doitms-com/open-source-house/desenhos/mapa-vaos/dc-t1.md

# Mapa de vãos — DC-T1

Quadro de referência gerado a partir do modelo geométrico do DC-T1 (estado base, sem opções). Material de referência: não é projecto de execução nem dispensa profissionais habilitados (ver o aviso da publicação, AVISO.md).

**Total: 11 vãos** (7 janelas, 2 portas exteriores, 2 portas interiores).

| ID | Tipo | Orientação | Largura (m) | Altura (m) | Peitoril (m) | Área (m²) | Batente | Descrição pública | Centro X (m) | Centro Y (m) | Centro Z (m) | Material caixilho | Vidro | U_f (W/m²·K) | U_w global (W/m²·K) | g_T,vi | R_w + C + Ctr (dB) | Permeabilidade NP EN 12207 | Verificação (indicativa) |
|---|---|---|---|---|---|---|---|---|---|---|---|---|---|---|---|---|---|---|---|
| J01 | janela | Sul | 1.20 | 1.20 | 1.04 | 1.44 | direita | Janela — Sul | 2.31 | 0.12 | 1.64 | Alumínio RPT (poliamida 24 mm) | Vidro duplo 4 (low-e) + 16 Ar + 4 mm | 2.80 | 1.40 | 0.50 | 32 (-1; -4) | 4 | REH §6 OK · RECS-A 26 dB OK · NP EN 14351-1 |
| J02 | janela | Sul | 0.60 | 0.60 | 1.71 | 0.36 | basculante | Janela — Sul | 7.58 | 0.12 | 2.01 | Alumínio RPT (poliamida 24 mm) | Vidro duplo translúcido 4-16Ar-4 | 2.80 | 1.60 | 0.40 | 30 (-1; -3) | 4 | REH §6 OK (ventilação IS) · NP EN 14351-1 |
| J03 | janela | Este | 1.20 | 1.20 | 1.04 | 1.44 | direita | Janela — Este | 8.88 | 4.49 | 1.64 | Alumínio RPT (poliamida 24 mm) | Vidro duplo 4 (low-e) + 16 Ar + 4 mm | 2.80 | 1.40 | 0.50 | 32 (-1; -4) | 4 | REH §6 OK · RECS-A 26 dB OK · NP EN 14351-1 |
| J04 | janela | Norte | 0.90 | 1.30 | 0.80 | 1.17 | direita | Janela — Norte | 1.85 | 5.88 | 1.45 | Alumínio RPT (poliamida 24 mm) | Vidro duplo 4 (low-e) + 16 Ar + 4 mm | 2.80 | 1.40 | 0.50 | 32 (-1; -4) | 4 | REH §6 OK · RECS-A 26 dB OK · NP EN 14351-1 |
| J05 | janela | Norte | 0.90 | 1.30 | 0.80 | 1.17 | esquerda | Janela — Norte | 4.80 | 5.88 | 1.45 | Alumínio RPT (poliamida 24 mm) | Vidro duplo 4 (low-e) + 16 Ar + 4 mm | 2.80 | 1.40 | 0.50 | 32 (-1; -4) | 4 | REH §6 OK · RECS-A 26 dB OK · NP EN 14351-1 |
| J06 | janela | Norte | 0.90 | 1.30 | 0.80 | 1.17 | direita | Janela — Norte | 6.00 | 5.88 | 1.45 | Alumínio RPT (poliamida 24 mm) | Vidro duplo 4 (low-e) + 16 Ar + 4 mm | 2.80 | 1.40 | 0.50 | 32 (-1; -4) | 4 | REH §6 OK · RECS-A 26 dB OK · NP EN 14351-1 |
| J07 | janela | Oeste | 1.20 | 1.20 | 1.04 | 1.44 | esquerda | Janela — Oeste | 0.12 | 4.49 | 1.64 | Alumínio RPT (poliamida 24 mm) | Vidro duplo 4 (low-e) + 16 Ar + 4 mm | 2.80 | 1.40 | 0.50 | 32 (-1; -4) | 4 | REH §6 OK · RECS-A 26 dB OK · NP EN 14351-1 |
| PE01 | porta_exterior | Sul | 0.90 | 2.10 | 0.00 | 1.89 | esquerda | Porta exterior — Sul | 5.45 | 0.12 | 1.05 | Madeira maciça + alma isolante PIR 30 mm | Sem envidraçado (porta cega) | 1.80 | 1.80 | — | 38 (-1; -3) | 3 | REH §6 OK · RECS-A 32 dB OK · NP EN 14351-1 |
| PE02 | porta_exterior | Norte | 0.90 | 2.10 | 0.00 | 1.89 | direita | Porta exterior — Norte | 7.59 | 5.88 | 1.05 | Madeira maciça + alma isolante PIR 30 mm | Sem envidraçado (porta cega) | 1.80 | 1.80 | — | 38 (-1; -3) | 3 | REH §6 OK · RECS-A 32 dB OK · NP EN 14351-1 |
| PI01 | porta_interior | — | 0.80 | 2.10 | 0.00 | 1.68 | esquerda | Porta interior | 3.90 | 3.00 | 1.05 | MDF lacado + alma colmeia | — | 2.50 | 2.50 | — | 25 (-1; -2) | 1 | DL 220/2008 (acústica entre compartimentos) OK |
| PI02 | porta_interior | — | 0.80 | 2.10 | 0.00 | 1.68 | esquerda | Porta interior | 6.45 | 2.45 | 1.05 | MDF lacado + alma colmeia | — | 2.50 | 2.50 | — | 25 (-1; -2) | 1 | DL 220/2008 (acústica entre compartimentos) OK |

Valores indicativos: não constituem verificação de conformidade (ver AVISO).

Convenções: medidas em metros; o centro do vão está no referencial do modelo (X para Este, Y para Norte, Z na vertical); a orientação é a da face exterior («—» onde não se aplica, como nas portas interiores).
