doitms-com/open-source-house/engenharia/iluminacao/iluminacao-artificial-dc-t1.md

> **Estado do conteúdo de engenharia** (cabeçalho gerado)
>
> Cabeçalho gerado a partir do próprio relatório: diz o que está provisório, por preencher ou por cumprir, antes do corpo.
>
> - **Assinatura.** Documento não assinado: sem assinatura de técnico habilitado; o relatório não foi revisto por técnico com inscrição válida.
>
> Documento técnico de referência: não é projecto e não serve para construir sem profissionais licenciados (ver `AVISO.md`, na raiz da publicação).

# Iluminação artificial — Casa Base T1 (`DC-T1`)

Projecto luminotécnico por compartimento (EN 12464-1 adaptada a residencial; LED CRI ≥ 90).

| Compartimento | Área (m²) | Lux alvo | Pontos LED | Potência (W) | CCT (K) |
|---|---|---|---|---|---|
| Sala / Cozinha aberta (com hall) | 22.95 | 200 | 4 | 64 | 3000 |
| Quarto principal | 11.34 | 100 | 2 | 16 | 2700 |
| Casa de banho | 6.08 | 200 | 3 | 17 | 3500 |
| Hall (aberto à sala) | 5.0 | 200 | 3 | 14 | 3000 |

**Potência LED total: 111 W** — circuito C1 (10 A / 1.5 mm²). Daylight factors em `lux-daylight-*.csv`.
