doitms-com/open-source-house/AVISO.md

# Aviso

Os desenhos, os ficheiros 3D, os cálculos e a documentação de serviços do DC-T1 (selo do modelo `c2d1ffeb79f1`) são **documentação técnica de referência**. Leia este aviso antes de usar qualquer ficheiro desta publicação.

1. **Não é um projecto.** Não é projecto de licenciamento nem de execução. Não foi submetida nem aprovada por nenhuma câmara municipal ou outra entidade, e não deve ser apresentada como tal.
2. **Não tem termo de responsabilidade.** Não tem termo de responsabilidade de arquitecto nem de engenheiro, nem assinatura de técnico. Não substitui o projecto subscrito por técnico com inscrição válida na Ordem dos Arquitectos (arquitectura) ou na Ordem dos Engenheiros (especialidades).
3. **Não construa sem profissionais habilitados.** Não construa nem encomende a construção de qualquer edifício a partir destes ficheiros sem projecto e direcção de obra por profissionais habilitados e sem as licenças e autorizações exigidas por lei. Esta documentação não serve para construir sem profissionais licenciados.
4. **Verifique tudo.** Verifique cada elemento contra o terreno, o plano director municipal, os regulamentos e a lei em vigor. Esta documentação não tem em conta o terreno, a zona, o clima local nem as condições de qualquer lote concreto.
5. **O conteúdo de engenharia é provisório.** Os cálculos são publicados com o estado que têm: provisórios, por rever e por assinar, com campos por preencher e resultados que podem não cumprir os requisitos. Cada relatório começa por um cabeçalho de estado que o diz, e o README tem a secção «Estado do conteúdo de engenharia». Nada aqui garante que a casa cumpra um regulamento.
6. **Sem garantia.** Na medida permitida pela lei, a documentação é fornecida «tal como está», sem garantia de exactidão, de completude ou de adequação a qualquer fim, e quem a usa fá-lo por sua conta e risco (ver a secção 5 do texto da licença, em [LICENSE](LICENSE)).

A licença CC BY-SA 4.0 permite copiar, adaptar e usar esta documentação; este aviso não a limita, mas aplica-se a todas as cópias e adaptações. As folhas de desenho repetem o aviso na legenda.
