doitms-com/open-source-house/MARCA.md

# Marca

«Doitms», «DOITMS», «Doitms Casa» e o logótipo da Doitms Casa são sinais distintivos reservados. **Não estão licenciados.**

A licença CC BY-SA 4.0 desta documentação cobre os direitos de autor sobre os desenhos, relatórios, tabelas e ficheiros 3D publicados. O texto da licença diz expressamente que os direitos de marca e de patente não são licenciados (secção 2(b)(2)) e que nada nela dá permissão para sugerir ligação, patrocínio ou aprovação do licenciante (secção 2(a)(6)).

## O que pode fazer

- Citar o nome «Doitms Casa» para identificar a origem desta documentação, com a atribuição pedida no README («Como citar»).
- Dizer, com verdade, que a sua obra se baseia na documentação do DC-T1 da Doitms Casa.
- Nas adaptações, remova o logótipo da legenda ou mantenha-o apenas como indicação de origem, sem o usar como marca própria.

## O que não pode fazer

- Usar «Doitms», «DOITMS», «Doitms Casa» ou o logótipo como nome ou sinal de um produto, de uma obra, de uma empresa, de um serviço, de um domínio ou de um repositório seu.
- Dar a uma obra derivada (uma adaptação desta documentação) o nome ou o logótipo, ou apresentá-la de modo que sugira que foi feita, aprovada ou patrocinada pela Doitms Casa.
- Omitir que alterou o material: a licença exige que indique as alterações.

Para qualquer outro uso do nome ou do logótipo, peça autorização antes, abrindo um *issue* neste repositório (https://github.com/doitms-com/open-source-house/issues).
