doitms-com/open-source-house/engenharia/memoria-reh.md

> **Estado do conteúdo de engenharia** (cabeçalho gerado)
>
> Cabeçalho gerado a partir do próprio relatório: diz o que está provisório, por preencher ou por cumprir, antes do corpo.
>
> - **Limitações que o próprio relatório imprime.** 2 pendências declaradas no corpo; não foram escondidas nem resolvidas aqui.
> - **Assinatura.** Documento não assinado: sem assinatura de técnico habilitado; o relatório não foi revisto por técnico com inscrição válida.
>
> Documento técnico de referência: não é projecto e não serve para construir sem profissionais licenciados (ver `AVISO.md`, na raiz da publicação).

# Doitms Casa — Verificação REH preparatória (DL 101-D/2020 + Portaria 138-I/2021)

**Âmbito.** Verificação dos requisitos mínimos de qualidade térmica
(U_max por elemento, factor solar dos vãos, ventilação Rph ≥ 0.4 h⁻¹)
para o projecto-tipo Doitms nas dimensões legais (T1 9.0 × 6.0 m,
Ab 54.0 m²),
na zona climática de referência (I1/V2).

**O que este documento NÃO é.** O cálculo sazonal completo do REH
(Nic ≤ Ni, Nvc ≤ Nv, Ntc ≤ Nt, com edifício de referência), a classe
energética e o pré-certificado/certificado SCE são actos próprios do
**Perito Qualificado (PQ)** — PENDENTES. Este quadro garante que o
projecto-tipo cumpre os requisitos mínimos à partida (a classe alvo A exige o cálculo completo do PQ).

| ZI | ZV | U parede (max) | U cob. (max) | U pav. (max) | U vãos (max) | g_T (max) | Rph | Conforme |
|---|---|---|---|---|---|---|---|---|
| I1 | V2 | 0.260 (0.50) | 0.18 (0.40) | 0.32 (0.50) | 1.40 (2.80) | 0.38 (0.56) | 0.45 | ✓ |

**Resultado: zona climática de referência (I1/V2) conforme** com os
requisitos mínimos da Portaria 138-I/2021.

**Notas de projecto.**

1. U das paredes obtido do modelo higrotérmico (ficheiro não publicado) para o envelope da zona climática de referência (I1/V2), JÁ COM a correcção de pontes térmicas dos
   montantes LGSF (método combinado EN ISO 6946 §6.7; ver ficheiro não publicado, coluna «U corrigido»); o PQ valida com
   cálculo numérico ISO 10211 se necessário.
2. Ventilação: admissão por grelhas higrorreguláveis
   na sala e quartos (compartimentos principais) + extracção mecânica
   permanente nos compartimentos de serviço — extractor higrorregulável por casa de banho (NP 1037-1: IS c/ banheira/duche ≥ 45 m³/h) e o exaustor de cozinha com conduta Ø125 (compra do cliente) na cozinha (NP 1037-1 cozinha ≥ 60 m³/h). Ponto
   eléctrico dedicado em ficheiro não publicado. Rph projecto 0.45
   h⁻¹ ≥ 0.4.
3. Vãos: caixilharia com corte térmico + vidro duplo low-e; estore
   exterior = sombreamento activado para g_T.
4. **Pendente (obrigatório antes da licença): cálculo REH completo +
   pré-certificado SCE por PQ; certificado SCE na conclusão.**
