doitms-com/open-source-house/servicos/ficha-scie-dc-t1.md

> **Estado do conteúdo de engenharia** (cabeçalho gerado)
>
> Cabeçalho gerado a partir do próprio relatório: diz o que está provisório, por preencher ou por cumprir, antes do corpo.
>
> - **Limitações que o próprio relatório imprime.** 1 pendência declarada no corpo; não foram escondidas nem resolvidas aqui.
> - **Campos.** Há 10 campos por preencher, entre parênteses rectos ([morada da obra], [freguesia], [concelho], [distrito], [nome do dono da obra], [NIF do dono da obra], [nome do técnico responsável], [n.º de inscrição do técnico], [distância], [localização do hidrante]): dependem do lote, do dono da obra ou de um técnico e estão vazios.
> - **Assinatura.** Documento não assinado: sem assinatura de técnico habilitado; o relatório não foi revisto por técnico com inscrição válida.
> - **Incoerência conhecida.** Cobertura descrita como telhado inclinado (versão anterior); a casa base tem cobertura plana (folha DA.02).
>
> Documento técnico de referência: não é projecto e não serve para construir sem profissionais licenciados (ver `AVISO.md`, na raiz da publicação).

# Ficha de Segurança Contra Incêndio — UT I, 1.ª Categoria · DC-T1

**Regime.** DL n.º 220/2008 (SCIE) + Portaria n.º 1532/2008. Habitação
unifamiliar — **Utilização-Tipo I**, 1 piso, altura ≤ 3.5 m,
**1.ª categoria de risco** ⇒ dispensa de projecto de
especialidade SCIE (Art. 17.º); sujeita a ficha de segurança (modelo ANEPC).

**Produto.** Casa Base T1 (`DC-T1`).
**Local da obra.** [morada da obra] · [freguesia] · [concelho] ·
[distrito]. **Dono da obra.** [nome do dono da obra], NIF [NIF do dono da obra].
**Técnico responsável.** [nome do técnico responsável], [n.º de inscrição do técnico].

---

## 1. Caracterização (valores do modelo paramétrico)

| Parâmetro | Valor |
|---|---|
| Utilização-tipo | I — habitacional |
| N.º de pisos acima do plano de referência | 1 |
| Altura da UT | ≤ 3.5 m |
| Área bruta | 54.0 m² |
| Categoria de risco | 1.ª |
| Local de risco | A (habitação) |
| N.º de saídas para o exterior | **2 (fachadas opostas, acima do exigido)** |
| Distância máxima a uma saída | ≤ 10.8 m (diagonal do envelope) |

Saídas (do modelo):

  1. 0.90 × 2.10 m — Porta principal — face Sul (hall)
  2. 0.90 × 2.10 m — Porta de serviço — Norte, inserto no vão Cozinha; 2.ª saída de emergência

## 2. Condições exteriores e acessibilidade dos meios de socorro

- Acesso de viaturas de socorro: via com largura ≥ 3,5 m até
  [distância] m da fachada (Portaria 1532/2008, Título II).
- Ponto de água / hidrante mais próximo: [localização do hidrante].
- Faixa de gestão de combustível: em espaço rural, 50 m (Lei 76/2017 /
  DL 82/2021 — SGIFR); recomendação Doitms: 30 m de perímetro
  desarborizado imediato + beirado anti-brasas de série.

## 3. Comportamento ao fogo dos elementos construtivos

| Elemento | Solução Doitms | Classe |
|---|---|---|
| Estrutura LGSF | aço galvanizado (A1) protegido por gesso cartonado 12.5 mm nas 2 faces interiores | R 30 (a confirmar OE) |
| Envolvente exterior | ETICS EPS grafitado com barras corta-fogo de lã mineral (A1) sobre TODOS os vãos e em coroamento/beirado + rainscreen de tijolo cerâmico maciço (A1) fixado mecanicamente | sistema B-s1,d0 · tijolo A1 |
| Cobertura | telha cerâmica (A1) sobre subtelha + asnas LGSF; beirado fechado anti-brasas (ember-proof, malha inox ≤ 2 mm nas entradas de ventilação) | B_ROOF (t1) |
| Tectos/paredes interiores | gesso cartonado standard/hidrófugo | A2-s1,d0 |
| Zonas húmidas | cimento-cola + azulejo cerâmico | A1 |
| Pavimento interior | cortiça selada com PU base água sobre betonilha | D_FL-s1 (cortiça); betonilha A1_FL |

## 4. Meios de detecção, alarme e primeira intervenção (base Doitms)

- Detectores de fumo autónomos (EN 14604) na sala e em cada quarto;
  detector CO na cozinha/zona técnica.
- Extintor pó ABC 6 kg junto à cozinha + manta ignífuga.
- Corte geral de energia na central técnica identificada; corte de água motorizado.
- **Evacuação: 2 saídas em fachadas opostas; a porta principal e a
  porta de serviço abrem PARA FORA (modelo).**
