doitms-com/open-source-house/desenhos/pdf/alcado-este.pdf

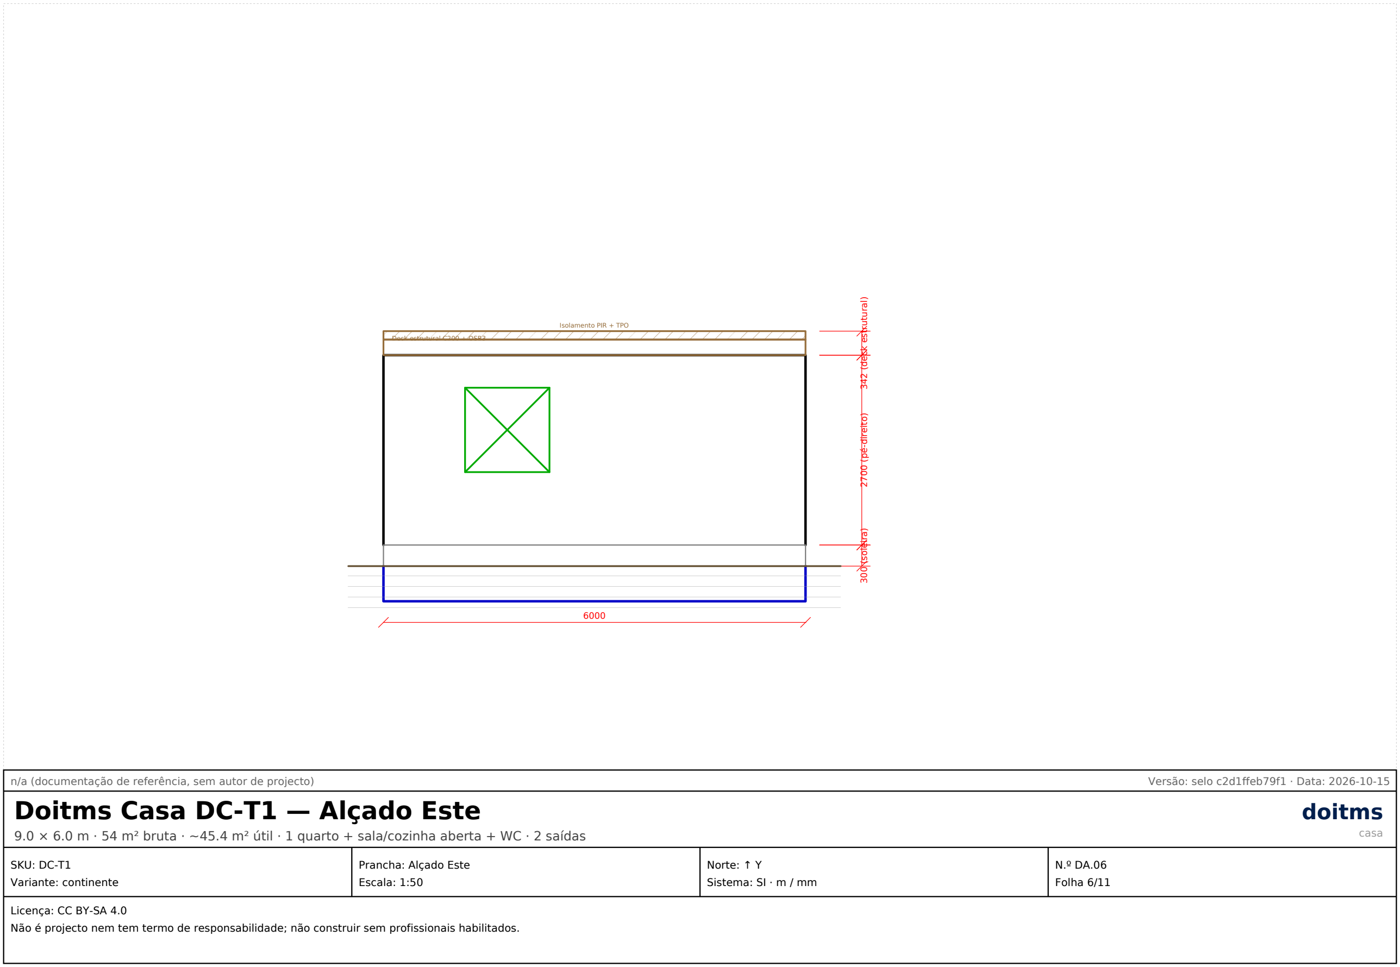
[picture p1: figure]
Deck estrutural C200 + OSB3; Isolamento PIR + TPO; Doitms Casa DC-T1 — Alçado Este; SKU: DC-T1 Variante: continente; Prancha: Alçado Este Escala: 1:50; Norte: ↑ Y Sistema: SI · m / mm; N.º DA.06 Folha 6/11; Licença: CC BY-SA 4.0; doitms; casa

300 (soleira) 2700 (pé-direito) 342 (deck estrutural)

n/a (documentação de referência, sem autor de projecto) | Versão: selo c2d1ffeb79f1 · Data: 2026-10-15

9.0 × 6.0 m · 54 m² bruta · ~45.4 m² útil · 1 quarto + sala/cozinha aberta + WC · 2 saídas

Não é projecto nem tem termo de responsabilidade; não construir sem profissionais habilitados.
