doitms-com/open-source-house/desenhos/pdf/cobertura.pdf

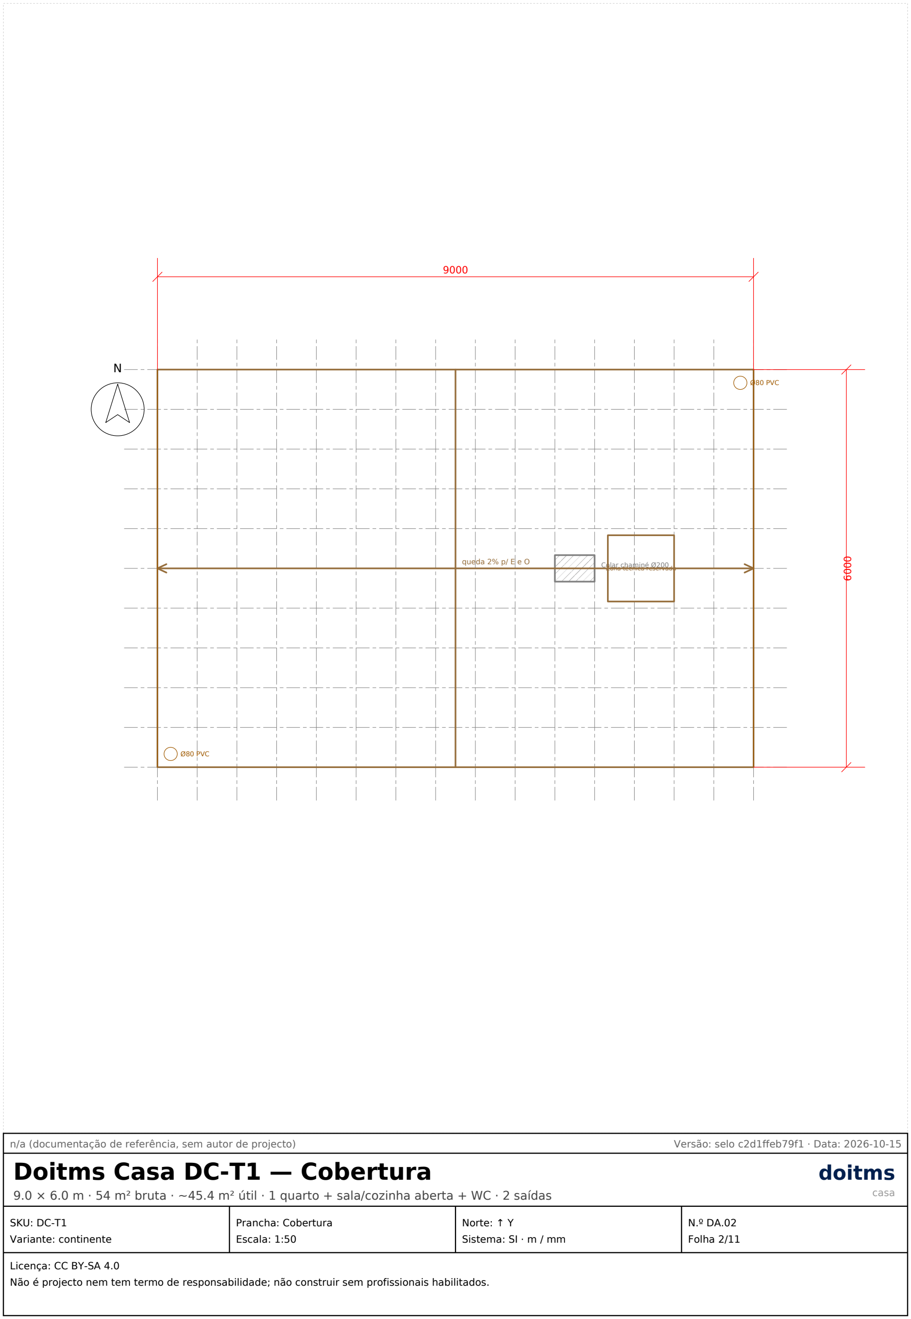
[picture p3: figure]
Ø80 PVC; Doitms Casa DC-T1 — Cobertura; SKU: DC-T1 Variante: continente; Prancha: Cobertura Escala: 1:50; Norte: ↑ Y Sistema: SI · m / mm; N.º DA.02 Folha 2/11; Licença: CC BY-SA 4.0; doitms; casa

Colar chaminé Ø200 queda 2% p/ E e O | Zona técnica reservada
n/a (documentação de referência, sem autor de projecto) | Versão: selo c2d1ffeb79f1 · Data: 2026-10-15

9.0 × 6.0 m · 54 m² bruta · ~45.4 m² útil · 1 quarto + sala/cozinha aberta + WC · 2 saídas

Não é projecto nem tem termo de responsabilidade; não construir sem profissionais habilitados.
