doitms-com/open-source-house/desenhos/pdf/fundacao.pdf

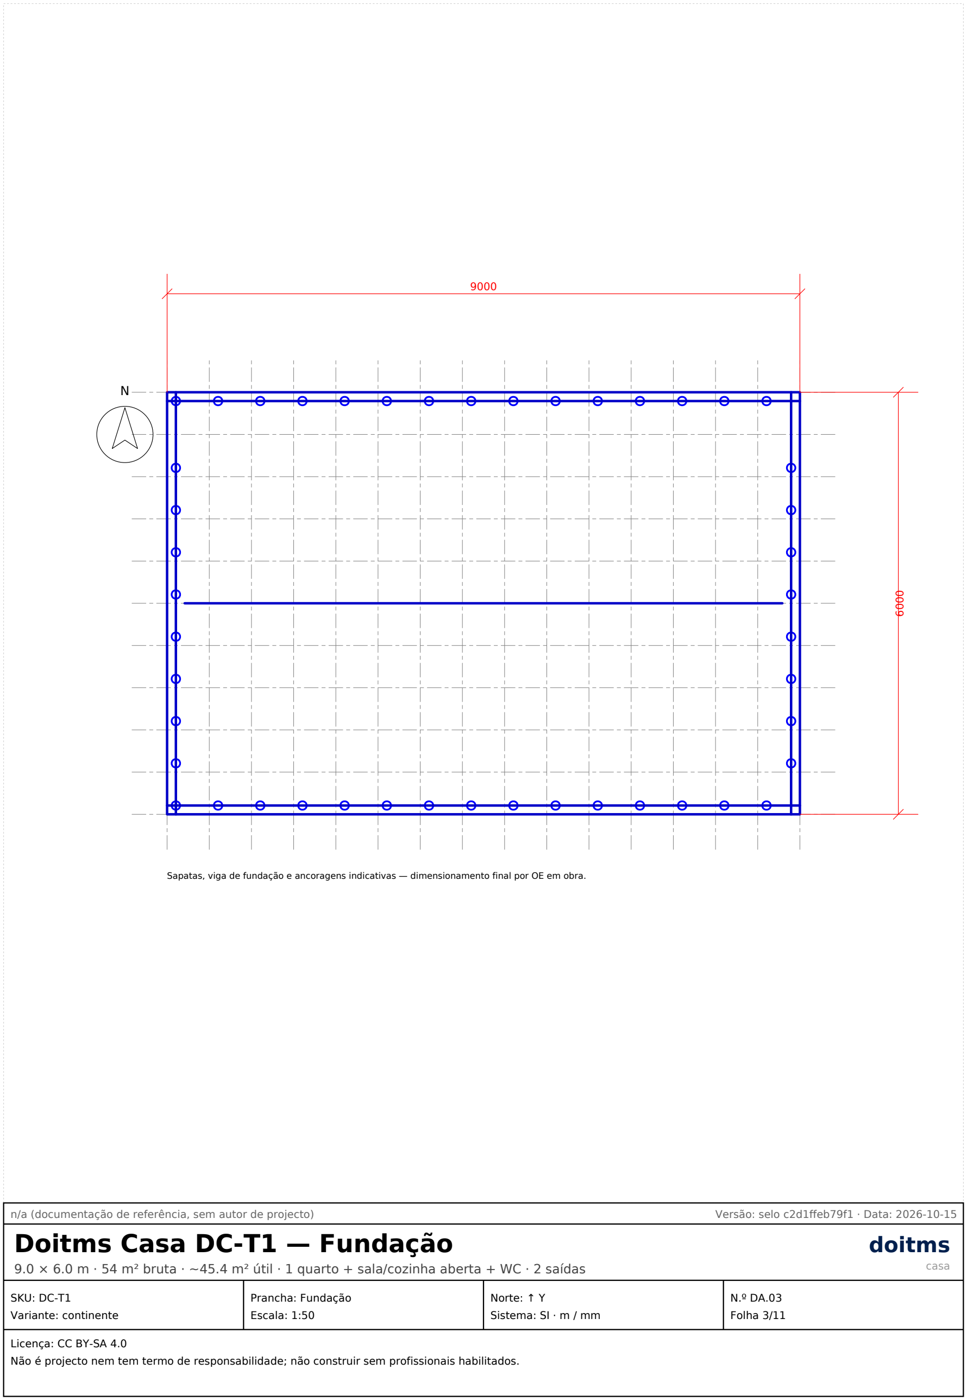
[picture p6: figure]
Doitms Casa DC-T1 — Fundação; SKU: DC-T1 Variante: continente; Prancha: Fundação Escala: 1:50; Norte: ↑ Y Sistema: SI · m / mm; N.º DA.03 Folha 3/11; Licença: CC BY-SA 4.0; doitms; casa

Sapatas, viga de fundação e ancoragens indicativas — dimensionamento final por OE em obra.

n/a (documentação de referência, sem autor de projecto) | Versão: selo c2d1ffeb79f1 · Data: 2026-10-15

9.0 × 6.0 m · 54 m² bruta · ~45.4 m² útil · 1 quarto + sala/cozinha aberta + WC · 2 saídas

Não é projecto nem tem termo de responsabilidade; não construir sem profissionais habilitados.
