doitms-com/open-source-house/desenhos/pdf/planta-mobiliario.pdf

Mesa de jantar 1,20×0,80

Sofá 1,70×0,80

Cama de casal 1,90×1,40

Cabeceira 0,10×1,40
Sanita

Lavatório

Base de duche

ML

Bancada cozinha 0,60×1,88

# Lava-loiça Placa / forno

Frigorífico

9000

6000

## Sala / Cozinha aberta (com hall)

22.95 m²

## Quarto principal

11.34 m²

## Casa de banho

6.08 m²

## Hall (aberto à sala)

5.00 m²

N

Planta de colocação de mobiliário — 12 peças: 6 fixas (entregues com a casa: bancadas, louça sanitária) + 6 de ocupação sugerida (camas, sofás, mesas — não incluídas). Dimensões em m (largura × profundidade), rótulo omitido quando não cabe na peça. Mobiliário e equipamento conforme ficheiro não publicado; instalações eléctricas/MEP e cotagem completa na DA.01.

n/a (documentação de referência, sem autor de projecto) | Versão: selo c2d1ffeb79f1 · Data: 2026-10-15

# Doitms Casa DC-T1 — Planta de mobiliário

9.0 × 6.0 m · 54 m² bruta · ~45.4 m² útil · 1 quarto + sala/cozinha aberta + WC · 2 saídas

## SKU: DC-T1 Variante: continente

## Prancha: Planta de mobiliário Escala: 1:50

## Norte: ↑ Y Sistema: SI · m / mm

| N.º DA.10 Folha 10/11

## Licença: CC BY-SA 4.0

Não é projecto nem tem termo de responsabilidade; não construir sem profissionais habilitados.

# doitms

| casa
