doitms-com/open-source-house/desenhos/dxf/cobertura.dxf

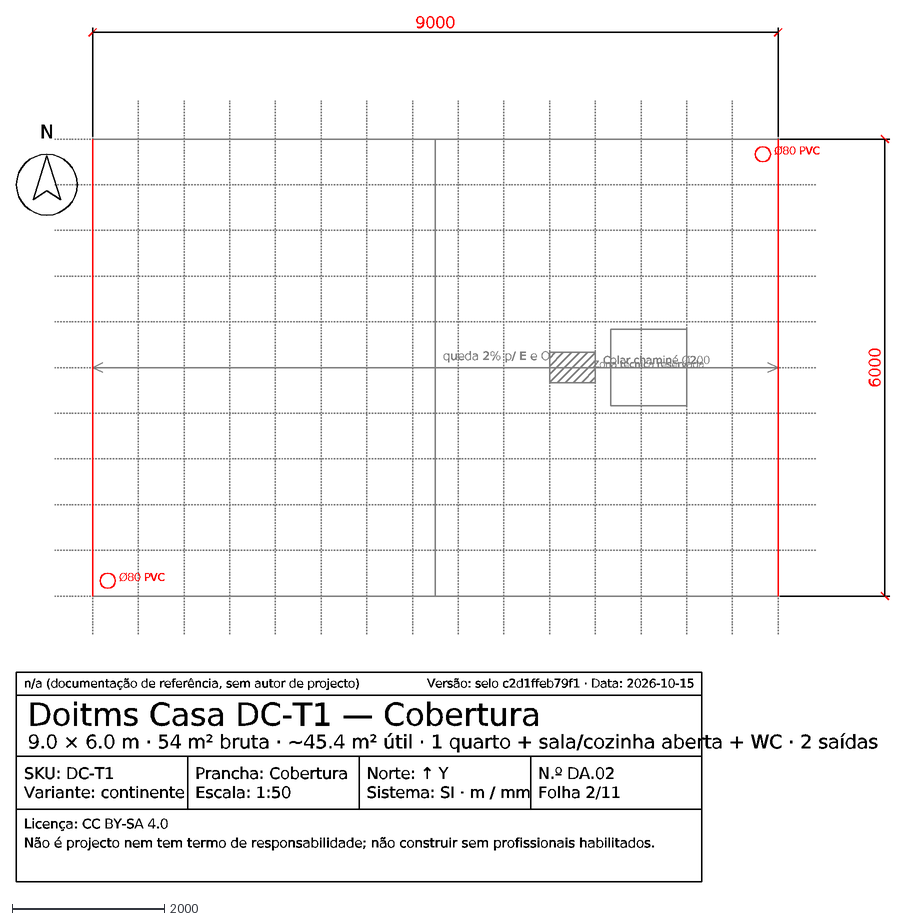
[picture p12: CAD file, 2026-10-18]
desenhos/dxf/cobertura.dxf
queda 2% p/ E e O
Ø80 PVC
Colar chaminé Ø200
Zona técnica reservada
N
9000
6000
n/a (documentação de referência, sem autor de projecto)
Versão: selo c2d1ffeb79f1 · Data: 2026-10-15
Doitms Casa DC-T1 — Cobertura
9.0 × 6.0 m · 54 m² bruta · ~45.4 m² útil · 1 quarto + sala/cozinha aberta + WC · 2 saídas
Licença: CC BY-SA 4.0
Não é projecto nem tem termo de responsabilidade; não construir sem profissionais habilitados.
SKU: DC-T1
Variante: continente
Prancha: Cobertura
Escala: 1:50
Norte: ↑ Y
Sistema: SI · m / mm
N.º DA.02
Folha 2/11
