doitms-com/open-source-house/desenhos/dxf/unifilar.dxf

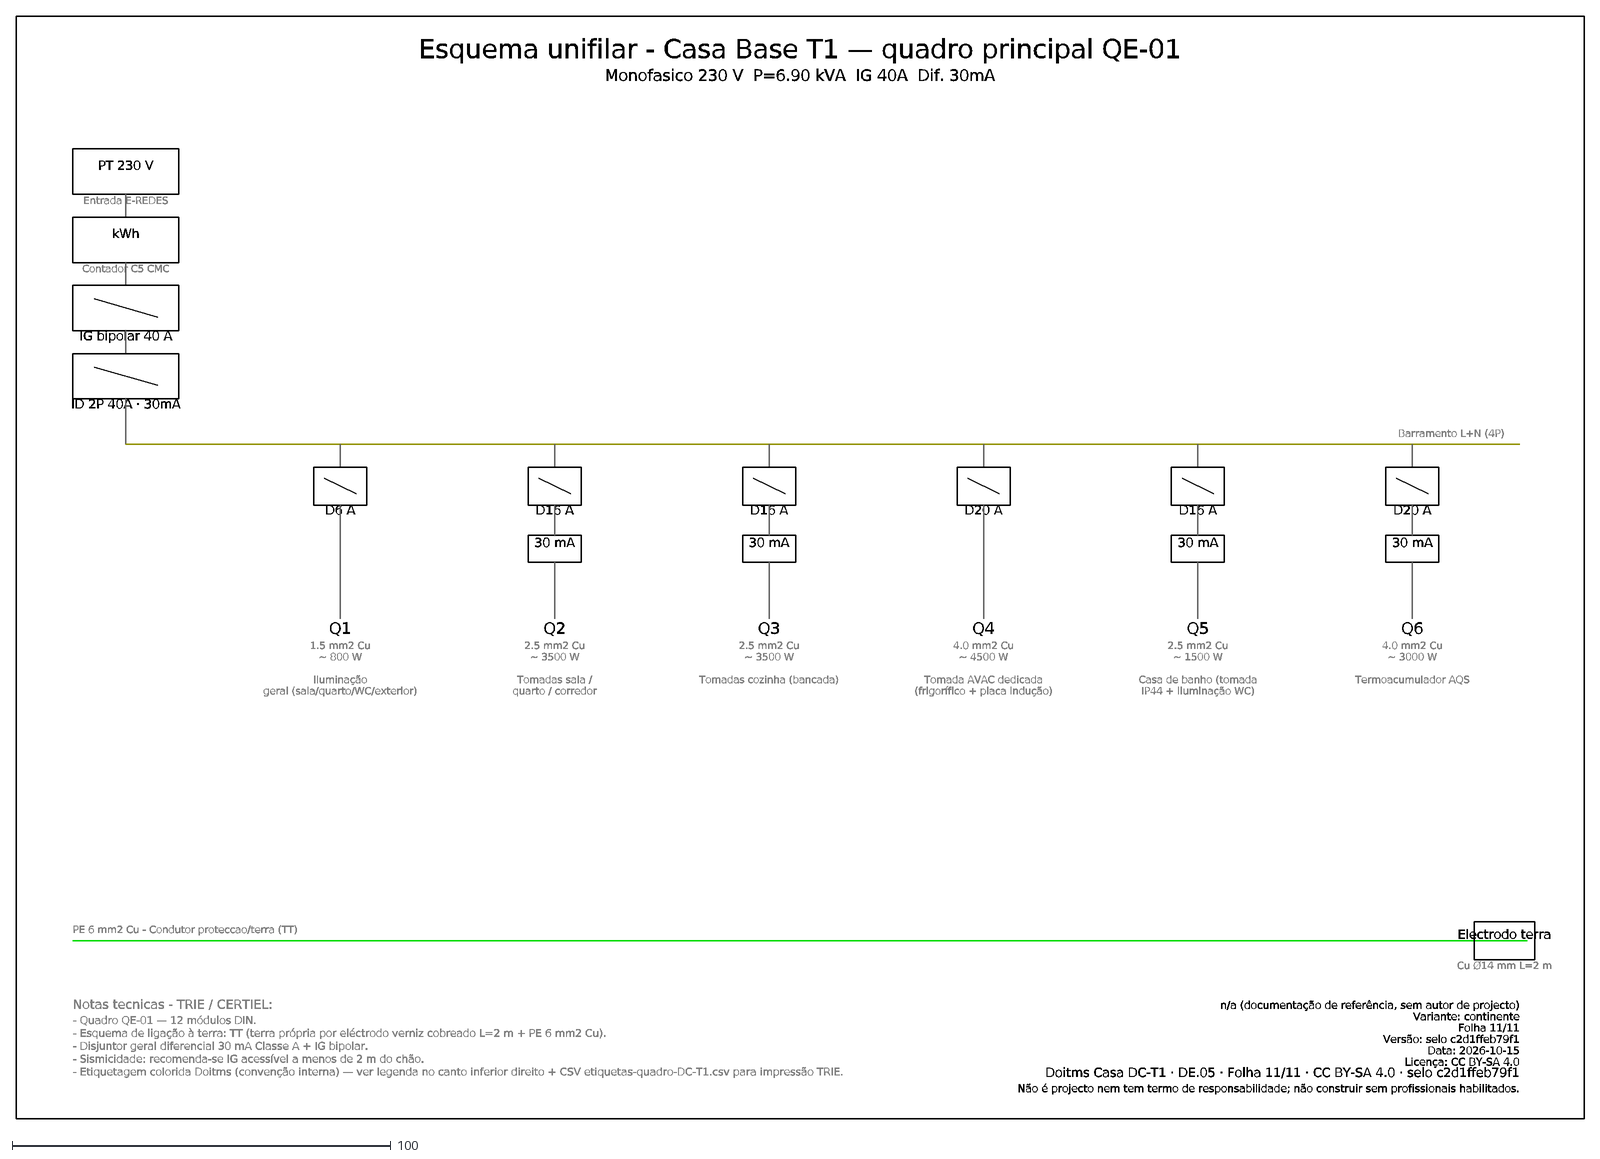
[picture p13: CAD file, 2026-10-18]
desenhos/dxf/unifilar.dxf
Esquema unifilar - Casa Base T1 — quadro principal QE-01
Monofasico 230 V P=6.90 kVA IG 40A Dif. 30mA
PT 230 V
Entrada E-REDES
kWh
Contador C5 CMC
IG bipolar 40 A
ID 2P 40A · 30mA
Barramento L+N (4P)
D6 A
Q1
1.5 mm2 Cu
~ 800 W
Iluminação
geral (sala/quarto/WC/exterior)
D16 A
30 mA
Q2
2.5 mm2 Cu
~ 3500 W
Tomadas sala /
quarto / corredor
Q3
Tomadas cozinha (bancada)
D20 A
Q4
4.0 mm2 Cu
~ 4500 W
Tomada AVAC dedicada
(frigorífico + placa indução)
Q5
~ 1500 W
Casa de banho (tomada
IP44 + iluminação WC)
Q6
~ 3000 W
Termoacumulador AQS
PE 6 mm2 Cu - Condutor proteccao/terra (TT)
Electrodo terra
Cu Ø14 mm L=2 m
Notas tecnicas - TRIE / CERTIEL:
- Quadro QE-01 — 12 módulos DIN.
- Esquema de ligação à terra: TT (terra própria por eléctrodo verniz cobreado L=2 m + PE 6 mm2 Cu).
- Disjuntor geral diferencial 30 mA Classe A + IG bipolar.
- Sismicidade: recomenda-se IG acessível a menos de 2 m do chão.
- Etiquetagem colorida Doitms (convenção interna) — ver legenda no canto inferior direito + CSV etiquetas-quadro-DC-T1.csv para impressão TRIE.
n/a (documentação de referência, sem autor de projecto)
Variante: continente
Folha 11/11
Versão: selo c2d1ffeb79f1
Data: 2026-10-15
Licença: CC BY-SA 4.0
Doitms Casa DC-T1 · DE.05 · Folha 11/11 · CC BY-SA 4.0 · selo c2d1ffeb79f1
Não é projecto nem tem termo de responsabilidade; não construir sem profissionais habilitados.
