doitms-com/open-source-house/desenhos/dxf/planta.dxf

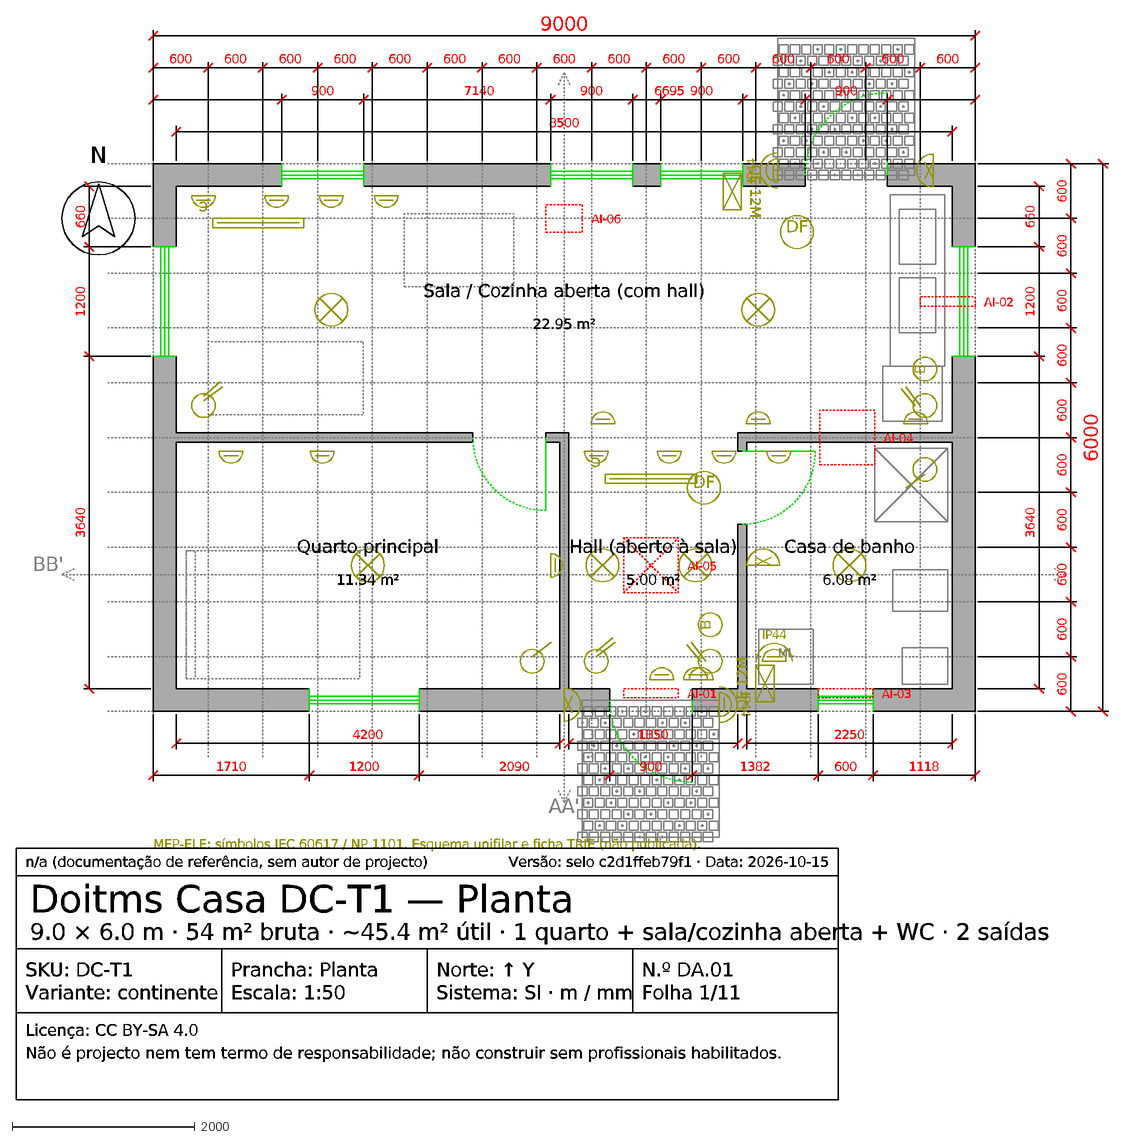
[picture p16: CAD file, 2026-10-18]
desenhos/dxf/planta.dxf
AA'
BB'
ML
B
C
DF
IP44
QE 12M
MEP-ELE: símbolos IEC 60617 / NP 1101. Esquema unifilar e ficha TRIE (não publicada).
AI-01
AI-02
AI-03
AI-04
AI-05
AI-06
Sala / Cozinha aberta (com hall)
22.95 m²
Quarto principal
11.34 m²
Casa de banho
6.08 m²
Hall (aberto à sala)
5.00 m²
N
4200
2250
1850
8500
1710
1200
2090
900
1382
600
1118
3640
660
7140
6695
9000
6000
n/a (documentação de referência, sem autor de projecto)
Versão: selo c2d1ffeb79f1 · Data: 2026-10-15
Doitms Casa DC-T1 — Planta
9.0 × 6.0 m · 54 m² bruta · ~45.4 m² útil · 1 quarto + sala/cozinha aberta + WC · 2 saídas
Licença: CC BY-SA 4.0
Não é projecto nem tem termo de responsabilidade; não construir sem profissionais habilitados.
SKU: DC-T1
Variante: continente
Prancha: Planta
Escala: 1:50
Norte: ↑ Y
Sistema: SI · m / mm
N.º DA.01
Folha 1/11
