doitms-com/open-source-house/(list of files, cad)

Other CAD files:
3d/T1.blend
