doitms-com/open-source-house/CHANGELOG.md

# Registo de alterações

Documentação técnica de referência do DC-T1 da Doitms Casa. Este ficheiro é gerado com cada publicação e descreve a publicação corrente; o histórico das versões anteriores está no histórico do repositório.

## Selo c2d1ffeb79f1

Data: 2026-10-15T13:56:08+01:00

Selo calculado sobre a árvore de trabalho com alterações não registadas; a publicação oficial faz-se a partir de um commit limpo.

- Selo do modelo: `c2d1ffeb79f1`. Identifica o código do modelo de que esta documentação foi gerada; muda sempre que o modelo muda.
- Folhas de desenho do DC-T1: 11, em SVG, DXF e PDF.
- Licença: CC BY-SA 4.0.
- Visão Geral pública: pendente; será incluída quando o gerador de documentação estiver pronto.
