doitms-com/open-source-house/desenhos/pdf/planta.pdf

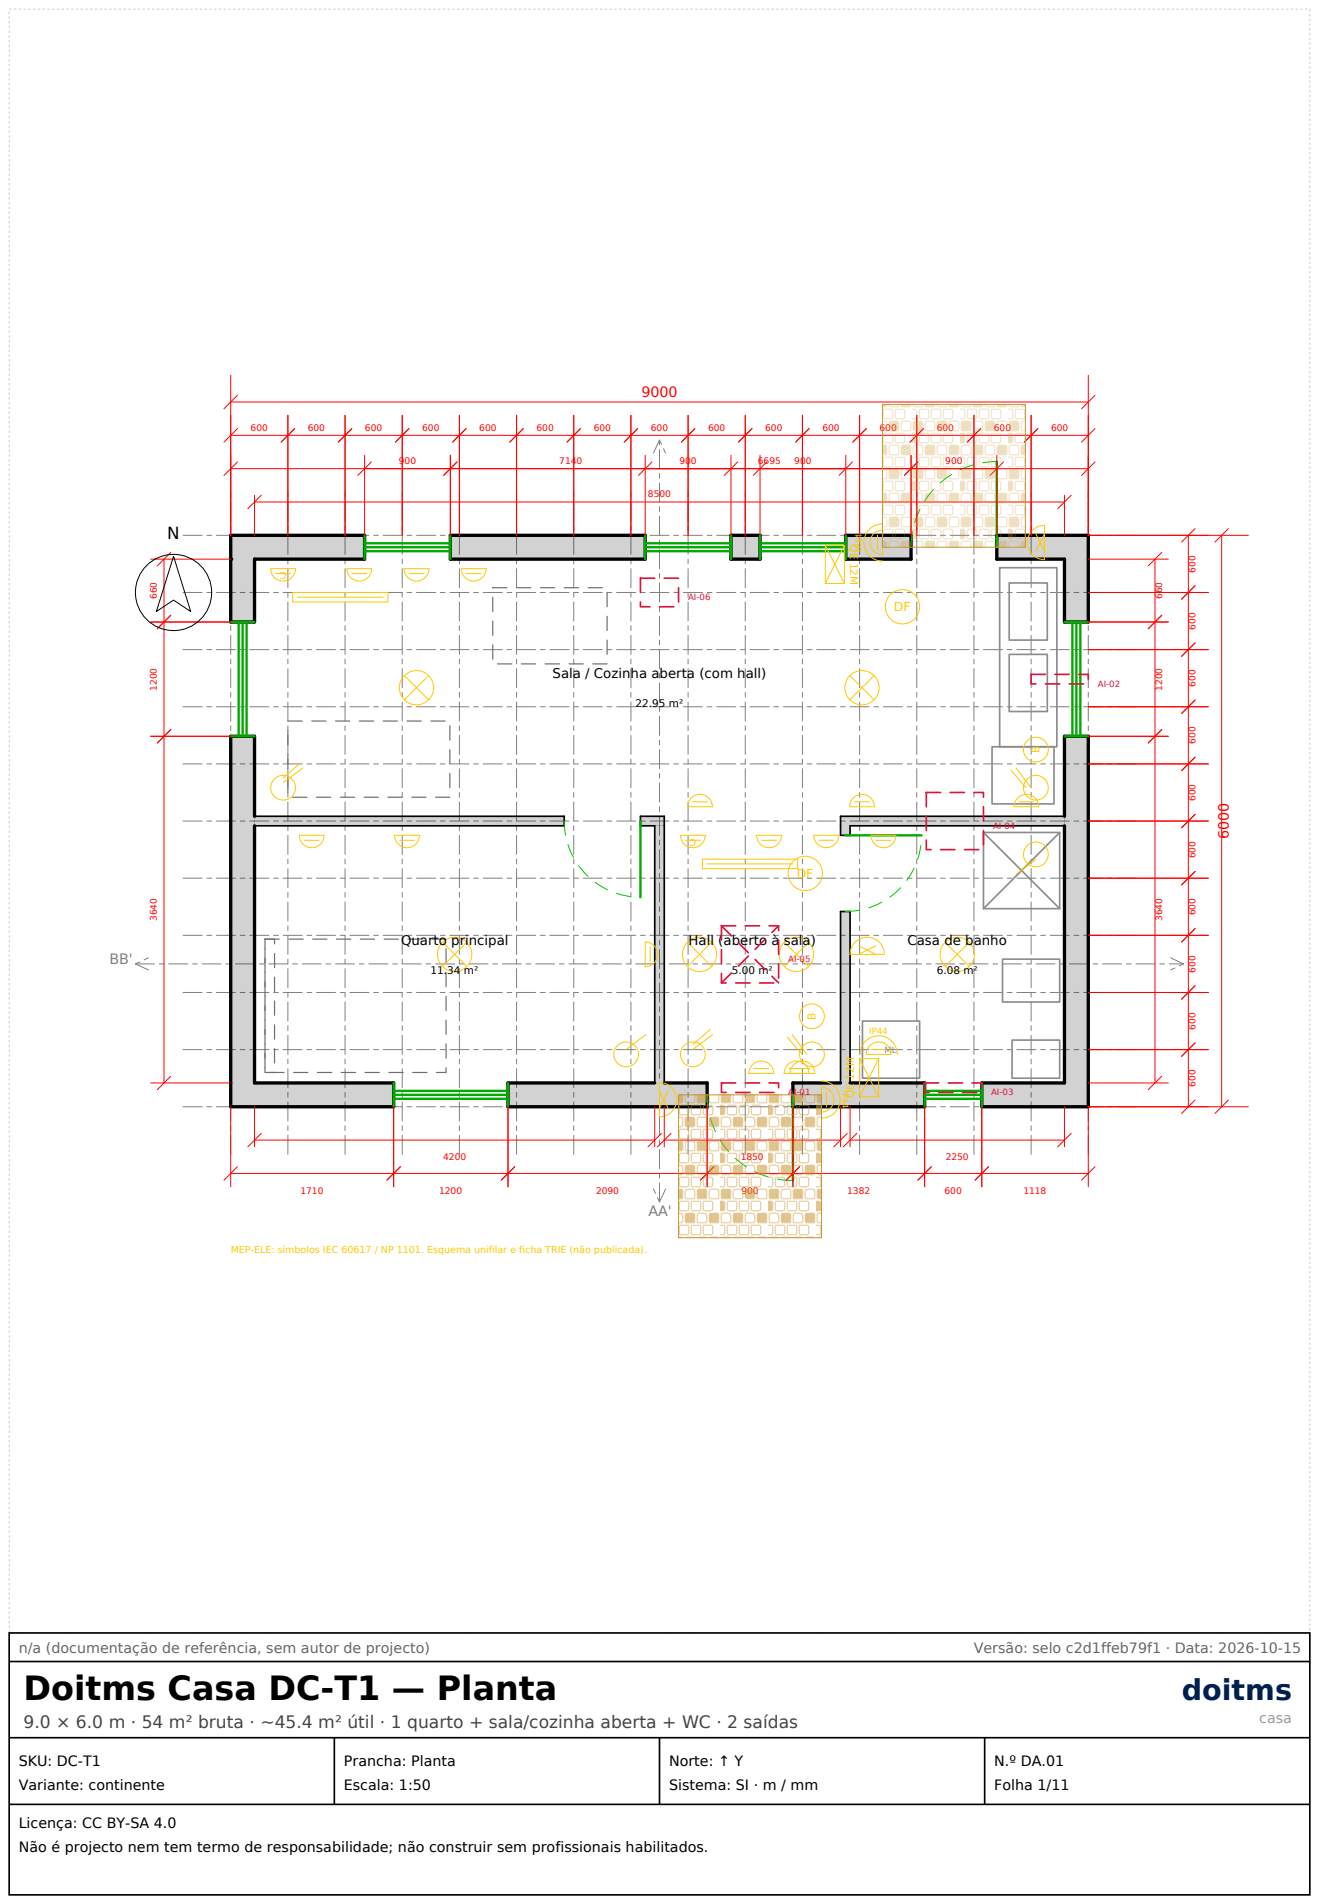
[picture p18: page 1]
Quarto principal; n/a (documentação de referência, sem autor de projecto); Versão: selo c2d1ffeb79f1 · Data: 2026-10-15; SKU: DC-T1 Variante: continente; Prancha: Planta Escala: 1:50; N.º DA.01 Folha 1/11; doitms; casa

Sala / Cozinha aberta (com hall)

Hall (aberto à sala)

Casa de banho

MEP-ELE: símbolos IEC 60617 / NP 1101. Esquema unifilar e ficha TRIE (não publicada).

Doitms Casa DC-T1 — Planta

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

Norte: ↑ Y
Sistema: SI · m / mm

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
