doitms-com/open-source-house/desenhos/pdf/unifilar.pdf

# Esquema unifilar — Casa Base T1 — quadro principal QE-01

Monofásico 230 V · P contratada: 6.90 kVA · IG bipolar 40 A · Diferencial geral 30 mA Classe A

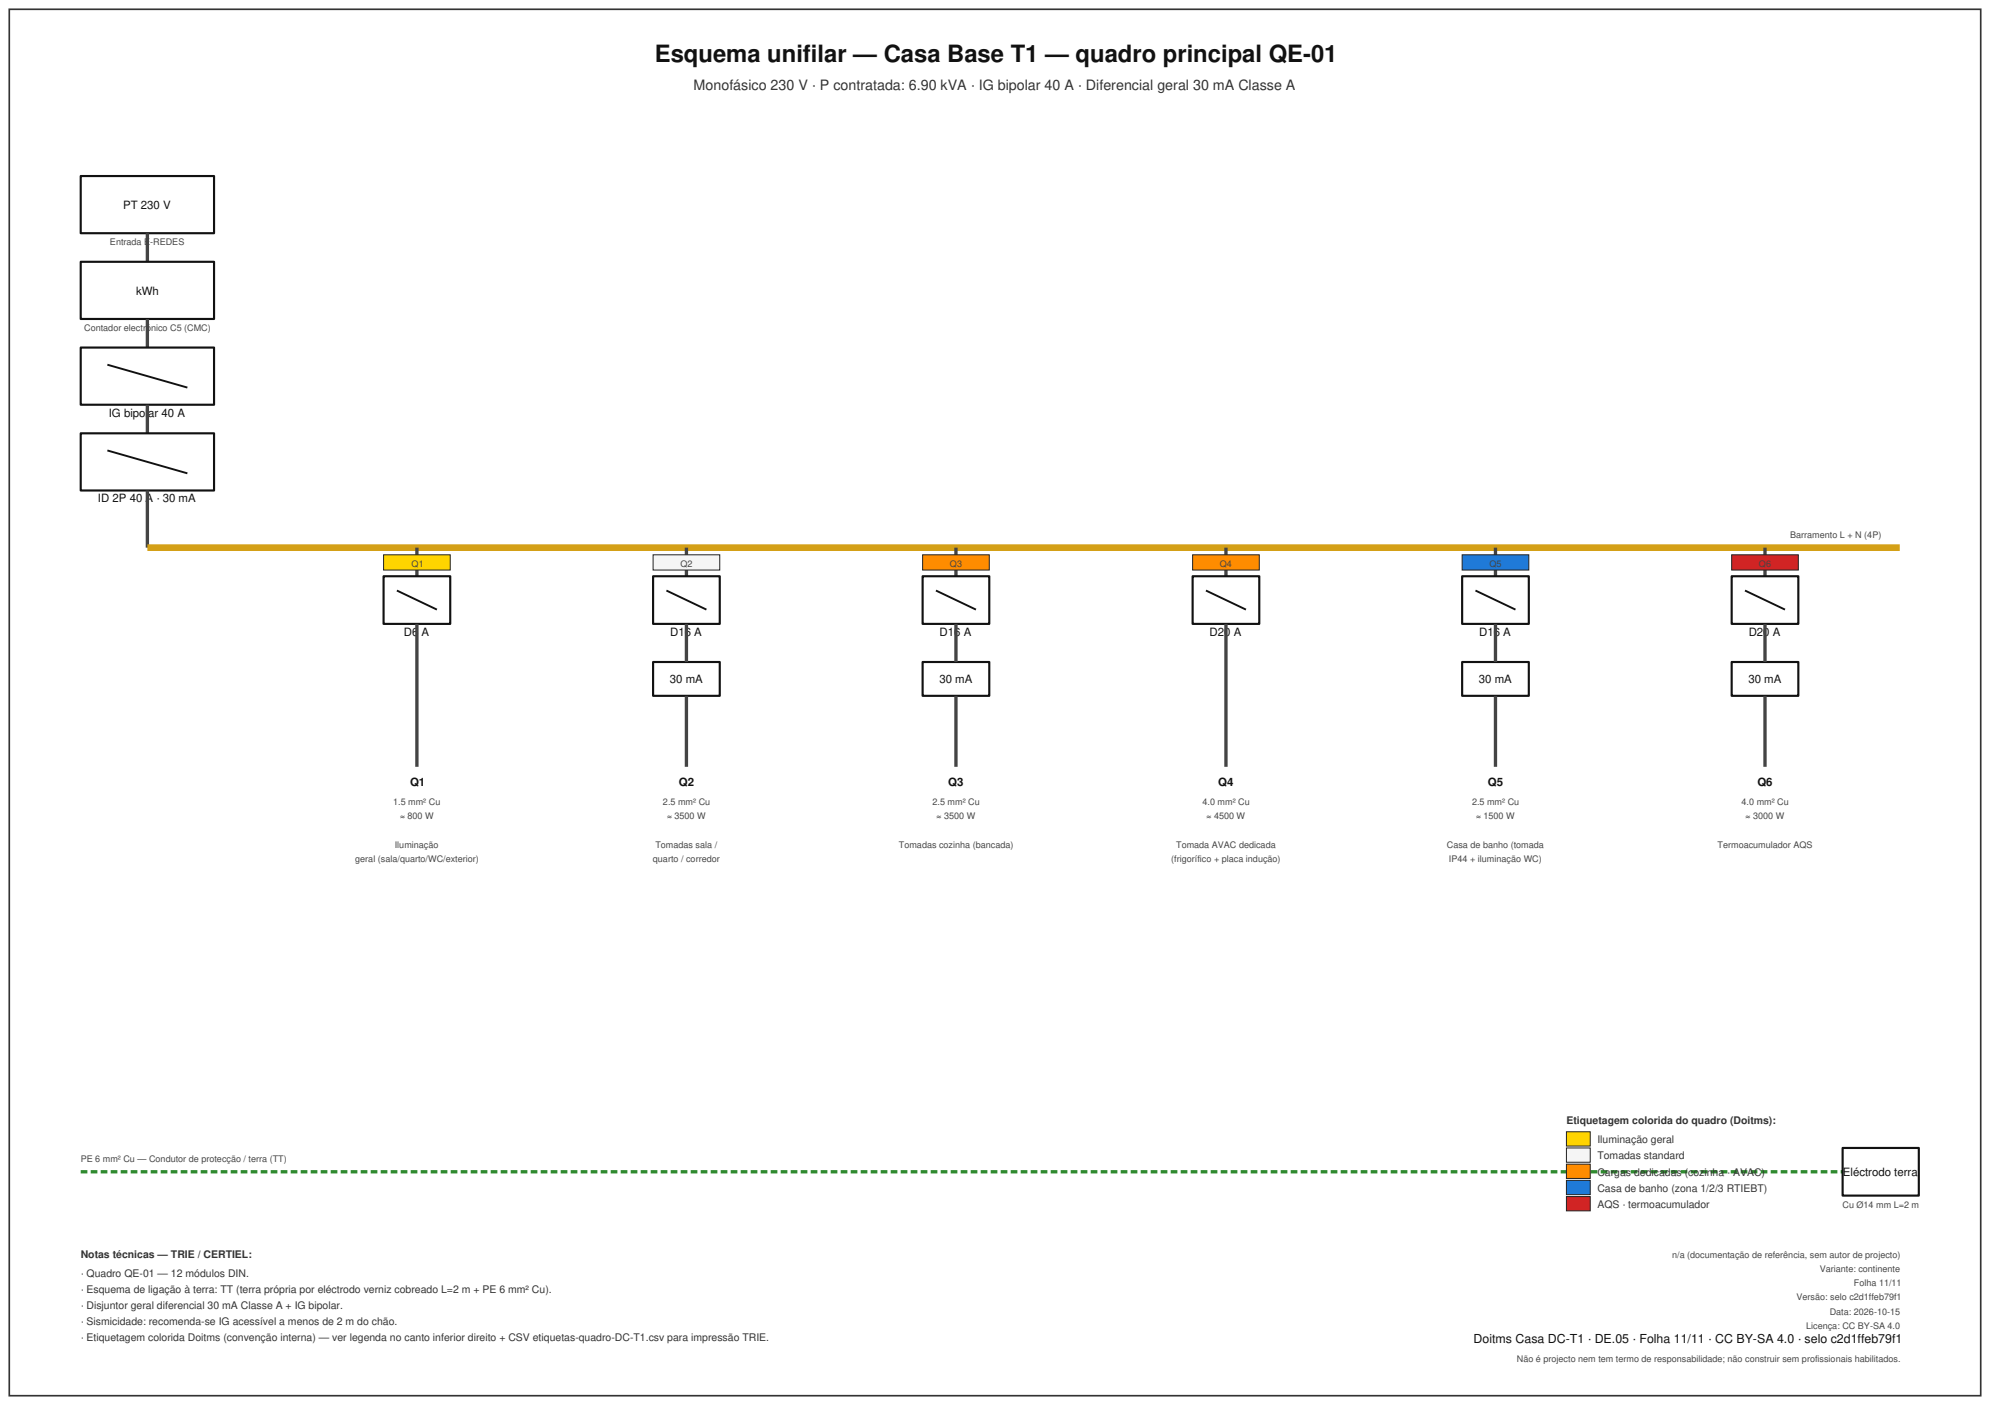
[picture p19: page 1]

Casa de banho (tomada
IP44 + iluminação WC)

geral (sala/quarto/WC/exterior)

Etiquetagem colorida do quadro (Doitms):

Iluminação geral
Tomadas standard
Cargas dedicadas (cozinha · AVAC)
Casa de banho (zona 1/2/3 RTIEBT)
AQS · termoacumulador

PE 6 mm² Cu — Condutor de protecção / terra (TT)

Notas técnicas — TRIE / CERTIEL:

n/a (documentação de referência, sem autor de projecto)

· Quadro QE-01 — 12 módulos DIN.
· Esquema de ligação à terra: TT (terra própria por eléctrodo verniz cobreado L=2 m + PE 6 mm² Cu).
· Disjuntor geral diferencial 30 mA Classe A + IG bipolar.
· Sismicidade: recomenda-se IG acessível a menos de 2 m do chão.
· Etiquetagem colorida Doitms (convenção interna) — ver legenda no canto inferior direito + CSV etiquetas-quadro-DC-T1.csv para impressão TRIE.

Data: 2026-10-15
Licença: CC BY-SA 4.0

Doitms Casa DC-T1 · DE.05 · Folha 11/11 · CC BY-SA 4.0 · selo c2d1ffeb79f1

Não é projecto nem tem termo de responsabilidade; não construir sem profissionais habilitados.
